Mflash777/CarclockHack/hardware/schematic/schematic.pdf

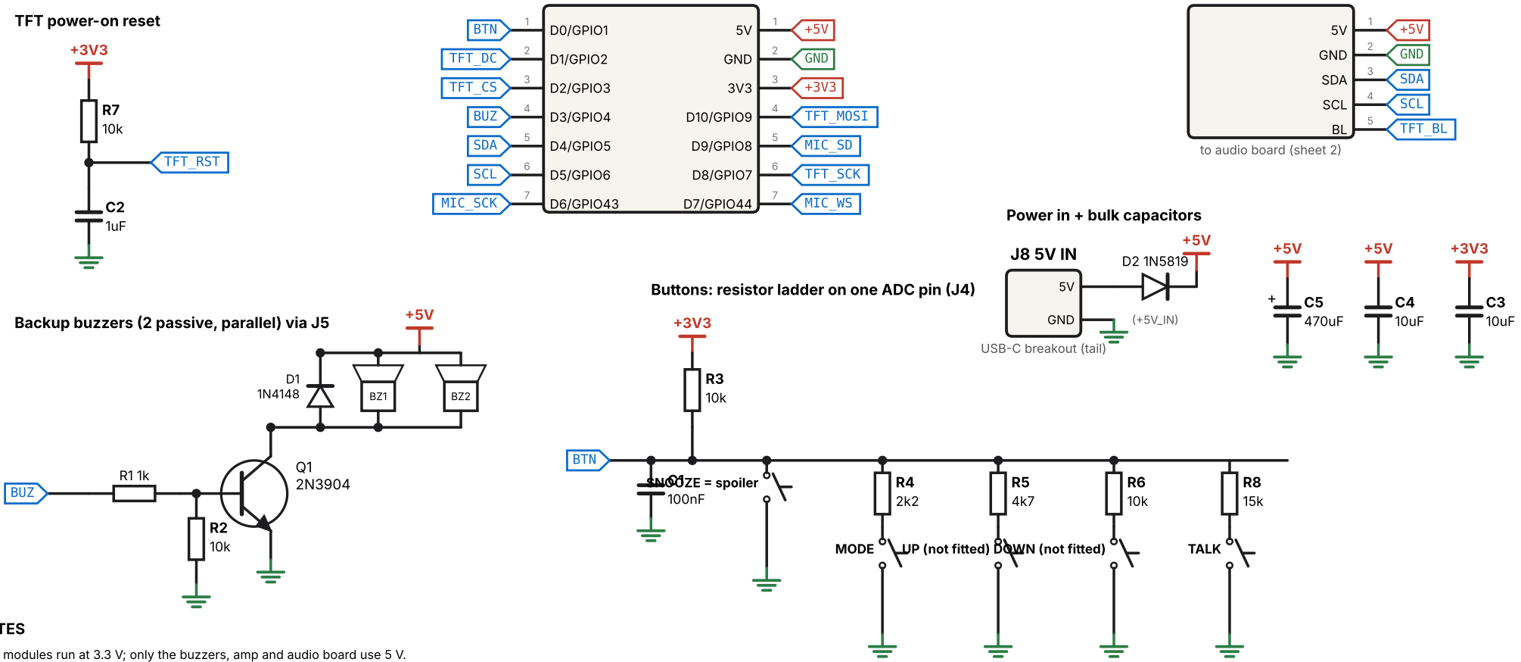
[picture p8: figure]
D0/GPIO1 ¹; D1/GPIO2 ²; D2/GPIO3 ³; D3/GPIO4 ⁴; D4/GPIO5 ⁵; D5/GPIO6 ⁶; D6/GPIO43 ⁷; GND; D10/GPIO9; D9/GPIO8; D8/GPIO7; D7/GPIO44; to audio board (sheet 2); SDA; SCL; Power in + bulk capacitors; USB-C breakout (tail); TFT power-on reset; SNOOZE = spoiler; MODE; UP (not fitted); DOWN (not fitted); TALK; BTN; TFT_DC; TFT_CS; BUZ; MIC_SCK; TFT_MOSI; MIC_SD; TFT_SCK; MIC_WS; TFT_BL; TFT_RST

## HackClock GT - clock carrier PCB

Hack Club Half Life | rev 3.2 | sheet 1/2

Same names = same net (net-label schematic)

## J1 TFT 2.0" ST7789 240x320

SPI, 3.3 V

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
## J2 HT16K33 7-segment

4-digit 0.56", I2C 0x70

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
## J3 DS3231 RTC

I2C 0x68, CR2032 backup

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
## J6 INMP441 microphone

I2S, 16 kHz, L/R = GND

VDD

1

GND

2

L/R | 3
WS | 4
SCK | 5
SD | 6

## U1 Seeed XIAO ESP32-S3

## J7 AUDIO link

### Backup buzzers (2 passive, parallel) via J5

### Buttons: resistor ladder on one ADC pin (J4)

Released 3.3 V | SNOOZE (spoiler) 0 V | MODE 0.6 V | TALK 1.98 V (UP / DOWN: leave the buttons off)

J4: GND, SNZ (spoiler switch), MODE_N, UP_N, DOWN_N (unused), TALK_N - each switch wires between its pin and GND

### NOTES

1. All modules run at 3.3 V; only the buzzers, amp and audio board use 5 V.
2. I2C bus (SDA/SCL) is shared: RTC 0x68, 7-segment 0x70, audio board 0x42.

Pull-ups are on the RTC / 7-seg modules (to 3.3 V).

3. DS3231 'ZS-042': use a CR2032 and remove the charging diode/resistor.
4. TFT pin order differs between sellers: wire by NAME.
5. TFT BLK is dimmed by the audio board (PWM on its GPIO4).
6. Power: 5 V 2-3 A USB-C into J8 (tail). The XIAO's own USB is for programming.

### GND

+3V3

### TFT_SCK

### TFT_MOSI

### TFT_RST

### TFT_DC

### TFT_CS

### TFT_BL

### GND

+3V3

### SDA

## SCL

### GND

+3V3

### SDA

## SCL

+3V3

### GND

### GND

### MIC_WS

### MIC_SCK

### MIC_SD

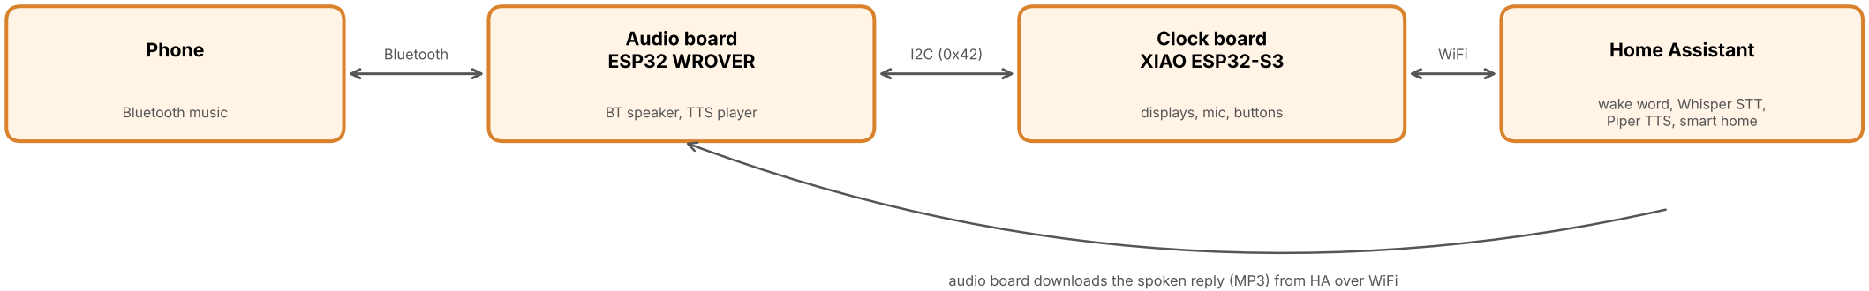
[picture p9: figure]
Phone; Bluetooth music; Audio board ESP32 WROVER; BT speaker, TTS player; Clock board XIAO ESP32-S3; displays, mic, buttons; Home Assistant; wake word, Whisper STT, Piper TTS, smart home; Bluetooth; WiFi
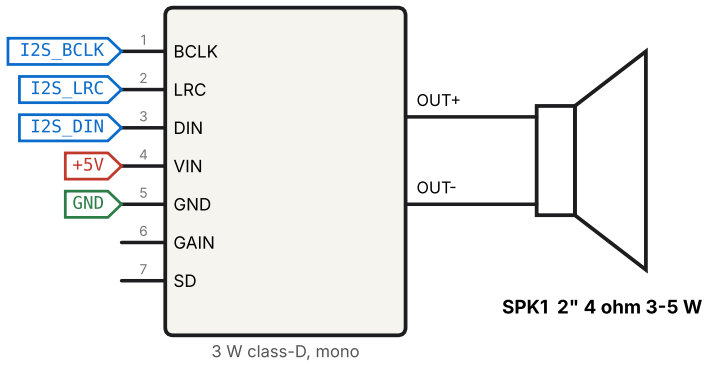
[picture p10: figure]
3 W class-D, mono; BCLK; LRC; DIN; VIN; GND; GAIN; OUT+; OUT-; SPK1 2" 4 ohm 3-5 W; I2S_BCLK; I2S_LRC; I2S_DIN
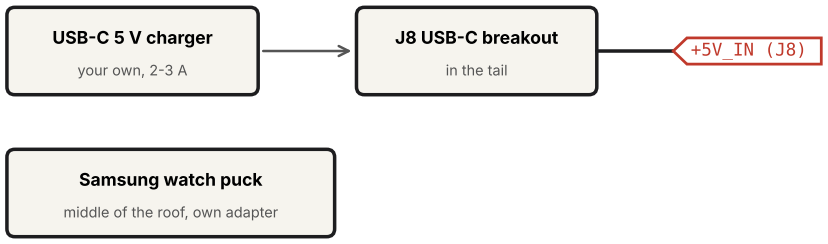
[picture p11: figure]
USB-C 5 V charger; your own, 2-3 A; J8 USB-C breakout; in the tail; Samsung watch puck; middle of the roof, own adapter

## HackClock GT - audio, power + system

Hack Club Half Life | rev 3.2 | sheet 2/2

Same names = same net (net-label schematic)

## System overview

audio board downloads the spoken reply (MP3) from HA over WiFi

## Audio board: ESP32-DevKitC-VE (WROVER-E)

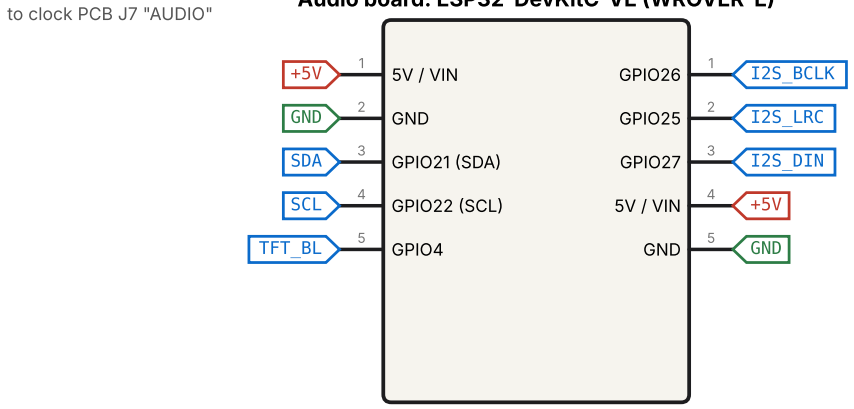
[picture p12: figure]
5V / VIN ¹; GND; GPIO21 (SDA); GPIO22 (SCL); GPIO4; to clock PCB J7 "AUDIO"; GPIO26; GPIO25; GPIO27; 5V / VIN; SDA; SCL; TFT_BL; I2S_BCLK; I2S_LRC; I2S_DIN

any classic ESP32 with PSRAM - NOT an S3/C3 (no Bluetooth Classic)

## MAX98357A I2S amplifier

GAIN, SD: leave open (9 dB gain, L+R mix)

## Audio board notes

- I2S_* nets are short Dupont wires from the ESP32 board straight to the amp (not on the PCB).
- Speaker wires: solder to the amp's screw terminal / pads; keep them twisted.
- Both boards run from the 5 V USB-C input (J8). The amp draws ~0.8 A at full volume.
- Flash the audio board once over its own USB port (firmware/audio-board), then it runs on its own.
- Phone pairing name: "HackClock". The clock board shows track title/artist on its "Now playing" page.
- WiFi details are sent to the audio board by the clock over I2C - nothing to configure.

## Power + charging

The watch puck is NOT wired to the PCB: its cable runs inside the body and out through the USB-A slot in the tail to its own adapter (or a multi-port charger).
