Mflash777/CarclockHack/BOM.csv

Item | Qty | Supplier | Cost/item | Total Cost | link
Seeed Studio XIAO ESP32-S3 (SKU 113991114) | 1 | Seeed Studio (US warehouse) | $7.49 | $7.49 | https://www.seeedstudio.com/XIAO-ESP32S3-p-5627.html
AITRIP ESP32-WROOM-32 Type-C dev board | 1 | Amazon | $8.99 | $8.99 | https://www.amazon.com/dp/B0DF2YJSHN
2.0 Inch IPS ST7789 240x320 SPI display | 1 | Amazon | $7.98 | $7.98 | https://www.amazon.com/dp/B0H6VZD3LW
DIYables 4-digit TM1637 LED display (5 pcs) | 1 | Amazon | $7.49 | $7.49 | https://www.amazon.com/dp/B0F4PSNH94
AOICRIE DS3231 RTC module (2 pcs) | 1 | Amazon | $7.59 | $7.59 | https://www.amazon.com/dp/B09STGJBGG
EGSCST INMP441 I2S microphone (3 pcs) | 1 | Amazon | $9.99 | $9.99 | https://www.amazon.com/dp/B0H1D77BN8
MAX98357A I2S amplifier (2 pcs) | 1 | Amazon | $6.89 | $6.89 | https://www.amazon.com/dp/B0DPJRLMDJ
DWEII 2 inch 4 ohm speaker (2 pack) | 1 | Amazon | $7.99 | $7.99 | https://www.amazon.com/dp/B0FVWL4LNG
Dirvcp 12mm momentary push buttons (5 pack) | 1 | Amazon | $6.69 | $6.69 | https://www.amazon.com/dp/B0FM8QKSM1
USB C breakout board (5 pcs) | 1 | Amazon | $5.99 | $5.99 | https://www.amazon.com/dp/B0GVK4TZXN
1000 pcs 1/4W metal film resistor kit | 1 | Amazon | $7.59 | $7.59 | https://www.amazon.com/dp/B0FT362FV2
METALLIXITY M3x8 self-tapping screws (100) | 1 | Amazon | $5.99 | $5.99 | https://www.amazon.com/dp/B0FJD3TWS1
Estimated total shipping | 1 |  | $0.00 | $0.00
Estimated total shipping | 1 |  |  | $7.63
