Mflash777/CarclockHack/case/stl/hackclock_windshield.stl

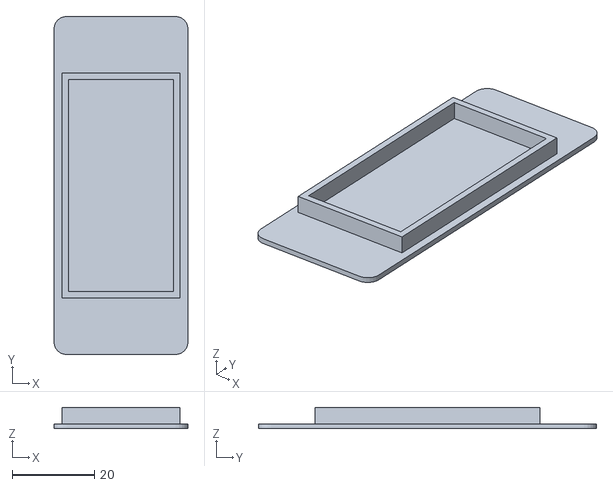
[picture p13: CAD file, 2026-11-02]
case/stl/hackclock_windshield.stl
32.5 x 82.0 x 5.20
