Mflash777/CarclockHack/case/stl/hackclock_wing.stl

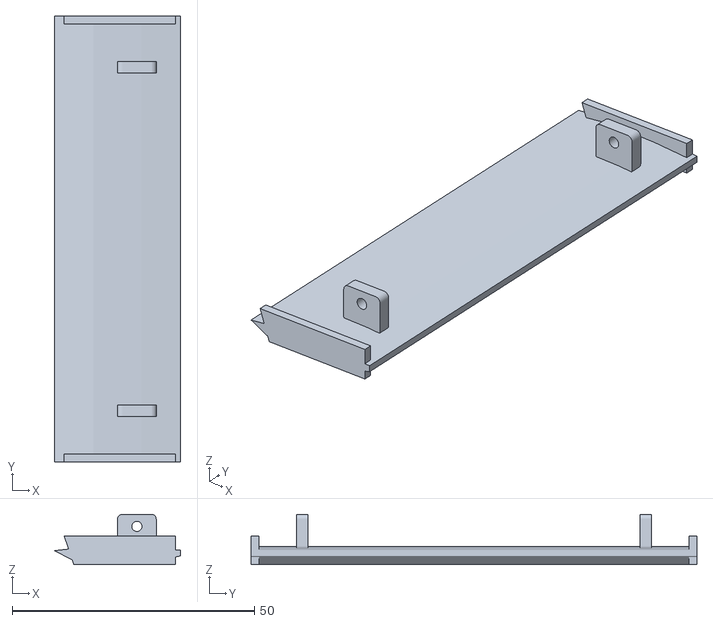
[picture p14: CAD file, 2026-11-02]
case/stl/hackclock_wing.stl
26.0 x 92.0 x 10.4
