Mflash777/CarclockHack/case/stl/hackclock_bottom.stl

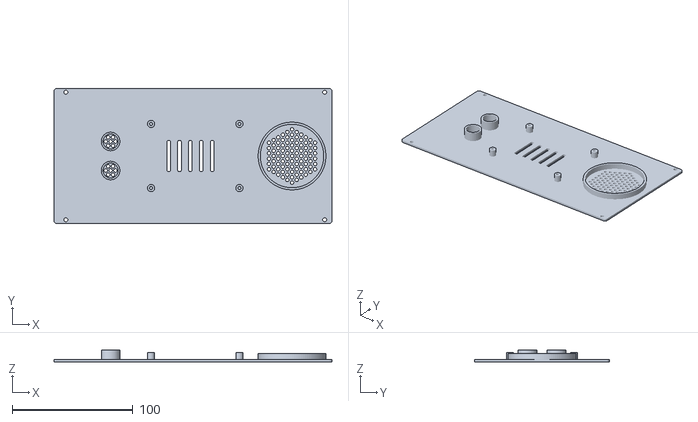
[picture p15: CAD file, 2026-11-02]
case/stl/hackclock_bottom.stl
229.8 x 111.4 x 10.0
