Mflash777/CarclockHack/case/stl/hackclock_side_glass.stl

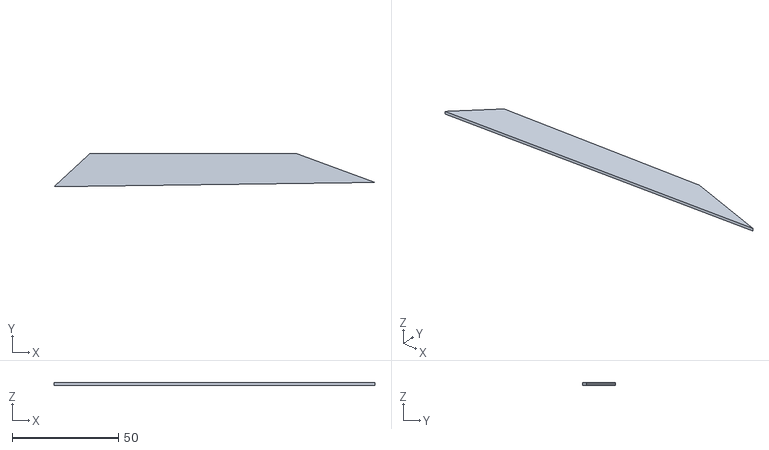
[picture p16: CAD file, 2026-11-02]
case/stl/hackclock_side_glass.stl
150.9 x 15.7 x 1.20
