Mflash777/CarclockHack/case/stl/hackclock_wheel.stl

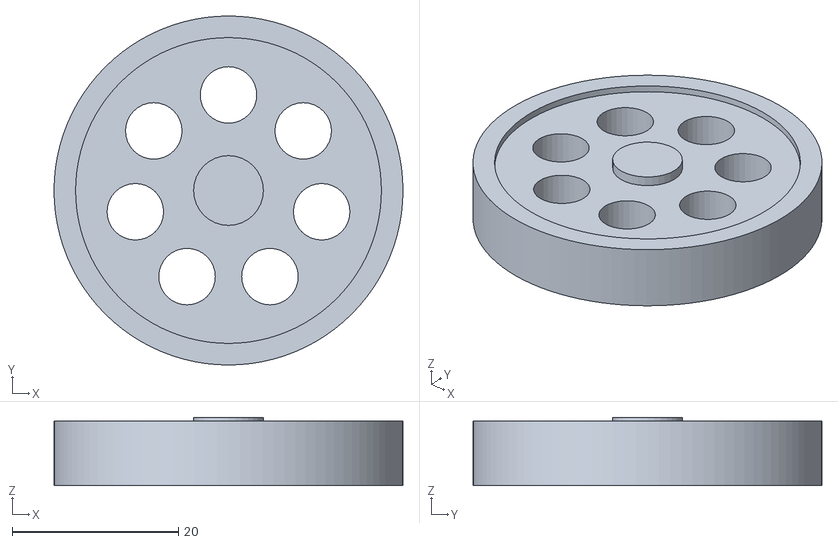
[picture p17: CAD file, 2026-11-02]
case/stl/hackclock_wheel.stl
42.0 x 42.0 x 8.20
