Mflash777/CarclockHack/case/stl/hackclock_body.stl

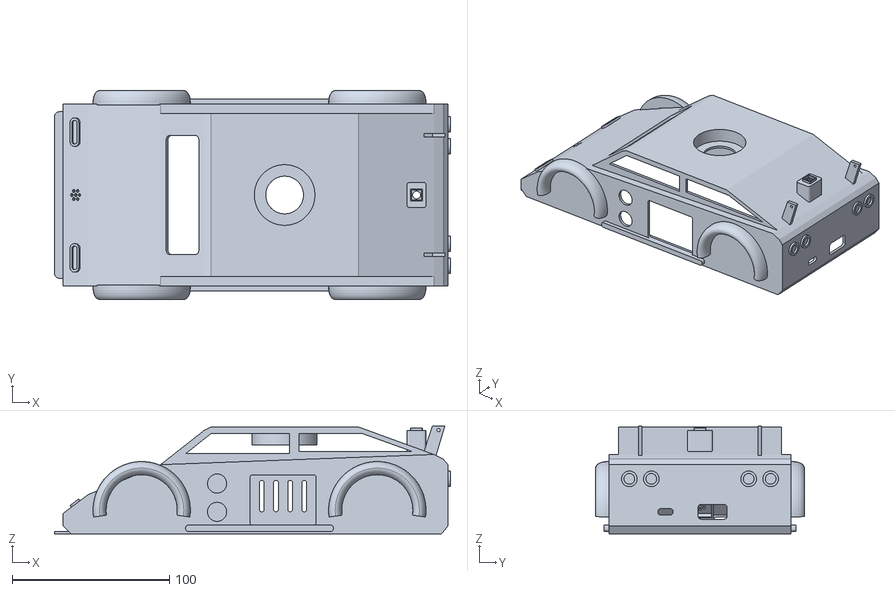
[picture p18: CAD file, 2026-11-02]
case/stl/hackclock_body.stl
252.1 x 133.0 x 68.5
