Mflash777/CarclockHack/(list of files, drawings)

Other design files:
hardware/pcb/pcb_data.json
