Mflash777/CarclockHack/hardware/pcb/hackclock.kicad_pcb

## KiCad design hardware/pcb/hackclock.kicad_pcb (2026-11-02)

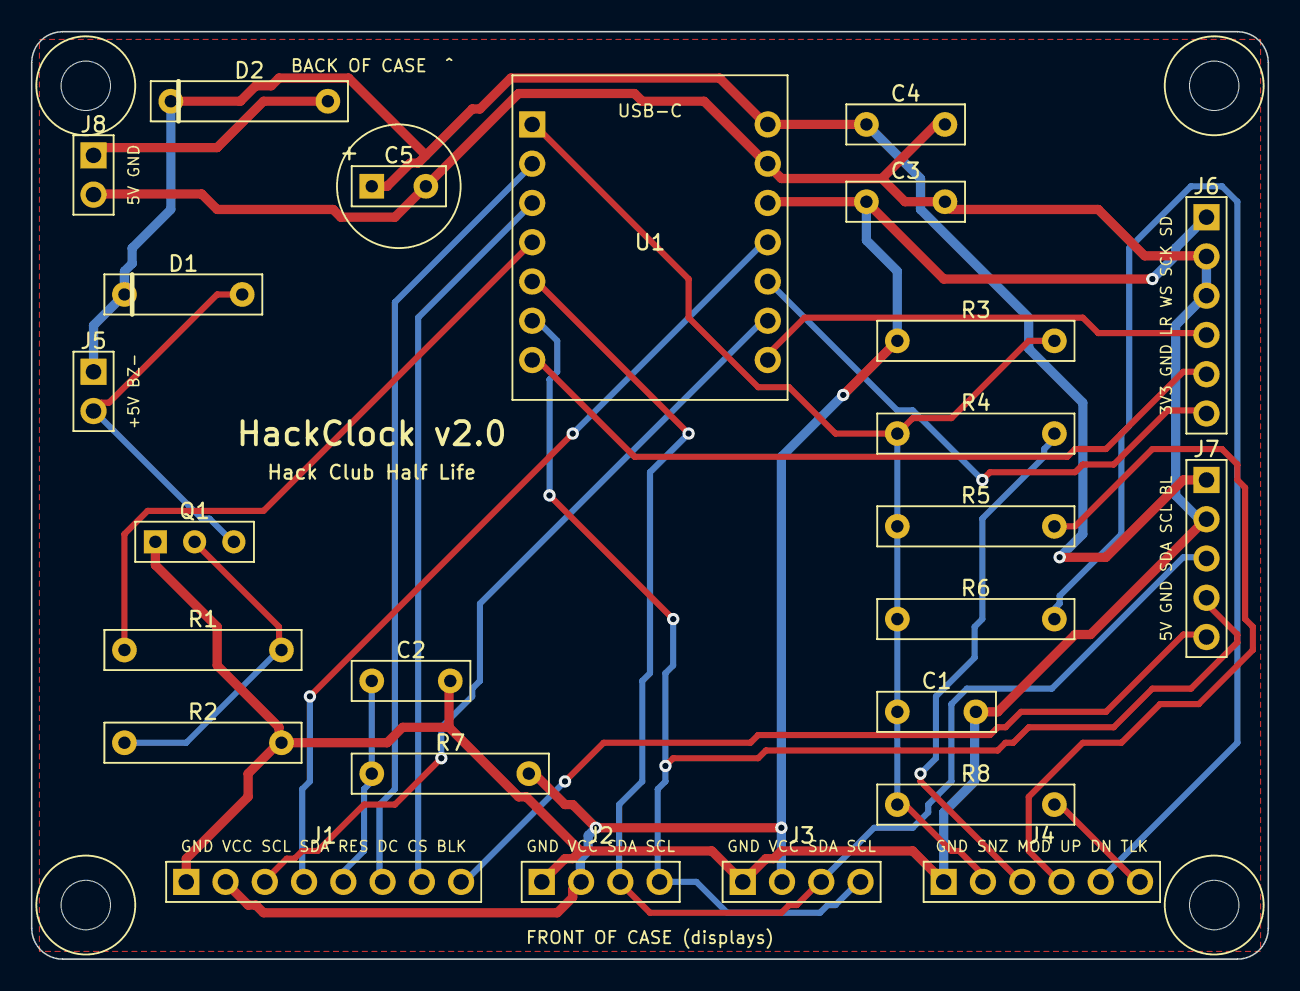
[picture p20: board hackclock.kicad_pcb from above]

Board: 2 copper layers, 80.0 x 60.0 mm, 29 parts (0 on the bottom side), 23 nets.

Parts:
C1: 100nF; C_Disc_P5.08mm
C2: 1uF; C_Disc_P5.08mm
C3, C4: 10uF; C_Disc_P5.08mm
C5: 470uF; CP_Radial_D8.0mm_P3.50mm
D1: 1N4148; D_DO-35_P7.62mm
D2: 1N5819; D_DO-41_P10.16mm
H1, H2, H3, H4: M3; MountingHole_3.2mm_M3
J1: TFT; PinHeader_1x08_P2.54mm
J2: 7SEG_I2C; PinHeader_1x04_P2.54mm
J3: RTC; PinHeader_1x04_P2.54mm
J4: BUTTONS; PinHeader_1x06_P2.54mm
J5: BUZZERS; PinHeader_1x02_P2.54mm
J6: MIC; PinHeader_1x06_P2.54mm
J7: AUDIO; PinHeader_1x05_P2.54mm
J8: 5V_IN; PinHeader_1x02_P2.54mm
Q1: 2N3904; TO-92_Inline
R1: 1k; R_Axial_P10.16mm
R2, R3, R6, R7: 10k; R_Axial_P10.16mm
R4: 2k2; R_Axial_P10.16mm
R5: 4k7; R_Axial_P10.16mm
R8: 15k; R_Axial_P10.16mm
U1: XIAO_ESP32S3; Seeed_XIAO_Socket

Connections:
+3V3: C3.1, J1.2, J2.2, J3.2, J6.1, R3.1, R7.2, U1.10
+5V: C4.1, C5.1, D1.1, D2.1, J5.1, J7.1, U1.8
+5V_IN: D2.2, J8.1
BTN: C1.1, J4.2, R3.2, R4.1, R5.1, R6.1, R8.1, U1.1
BUZ: R1.1, U1.4
BZ_N: D1.2, J5.2, Q1.3
DOWN_N: J4.5, R6.2
GND: C1.2, C2.2, C3.2, C4.2, C5.2, J1.1, J2.1, J3.1, J4.1, J6.2, J6.3, J7.2, J8.2, Q1.1, R2.2, U1.9
MIC_SCK: J6.5, U1.7
MIC_SD: J6.6, U1.12
MIC_WS: J6.4, U1.14
MODE_N: J4.3, R4.2
Q_B: Q1.2, R1.2, R2.1
SCL: J2.4, J3.4, J7.4, U1.6
SDA: J2.3, J3.3, J7.3, U1.5
TALK_N: J4.6, R8.2
TFT_BL: J1.8, J7.5
TFT_CS: J1.7, U1.3
TFT_DC: J1.6, U1.2
TFT_MOSI: J1.4, U1.11
TFT_RST: C2.1, J1.5, R7.1
TFT_SCK: J1.3, U1.13
UP_N: J4.4, R5.2
