Mflash777/CarclockHack/(commit log)

2026-11-02 added files fro project
    [hackclock.kicad_pcb, hackclock_body.stl, hackclock_bottom.stl, hackclock_side_glass.stl, hackclock_wheel.stl, hackclock_windshield.stl, hackclock_wing.stl, pcb_data.json]
2026-11-02 Sync HackClock Car from Half Life
    [BOM.csv]
2026-11-02 Update BOM.csv with new components and costs
    [BOM.csv]
2026-11-02 Revise BOM.csv with new components and links
    Updated BOM with new items and corrected supplier links.
    [BOM.csv]
2026-11-02 Revise BOM with additional components and details
    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
    [BOM.csv]
